Tasnia-Binte-Mamun/Circuit_design_EcoG_signal/BME_304_Project.pdf

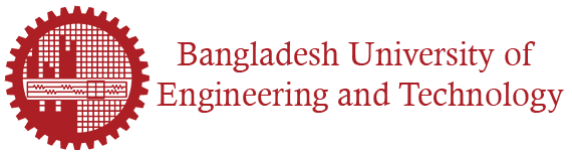
[picture p2: figure]

### Report on designing appropriate bio-signal measurement device

### for the ECoG signal

Course no: BME 304

Course Name: Biomedical Instrumentation and Measurements Sessional

Group No: 02

Date of submission: 28/08/2022

Submitted By | Submitted To
1.Tahmed Ahmed(1818006) | 1. Md. Kawsar Ahmed (https://bme.buet.ac.bd/profile/md-kawsar-ahmed/)
2.Atkia Atia Fariha(1818007) | Lecturer
3.Shamiur Rahman(1818008) | Dept. of Biomedical Engineering, BUET
4.Adhora Madhuri(1818009) | 2. Shams Nafisa Ali
5.Mahbuba Ferdaous(1818010) | Lecturer
6.Tasnia Binte Mamun(1818027) | Dept. of Biomedical Engineering, BUET
3. Samiul Based Shuvo
| Lecturer
| Dept. of Biomedical Engineering, BUET

## Circuit Schematics:

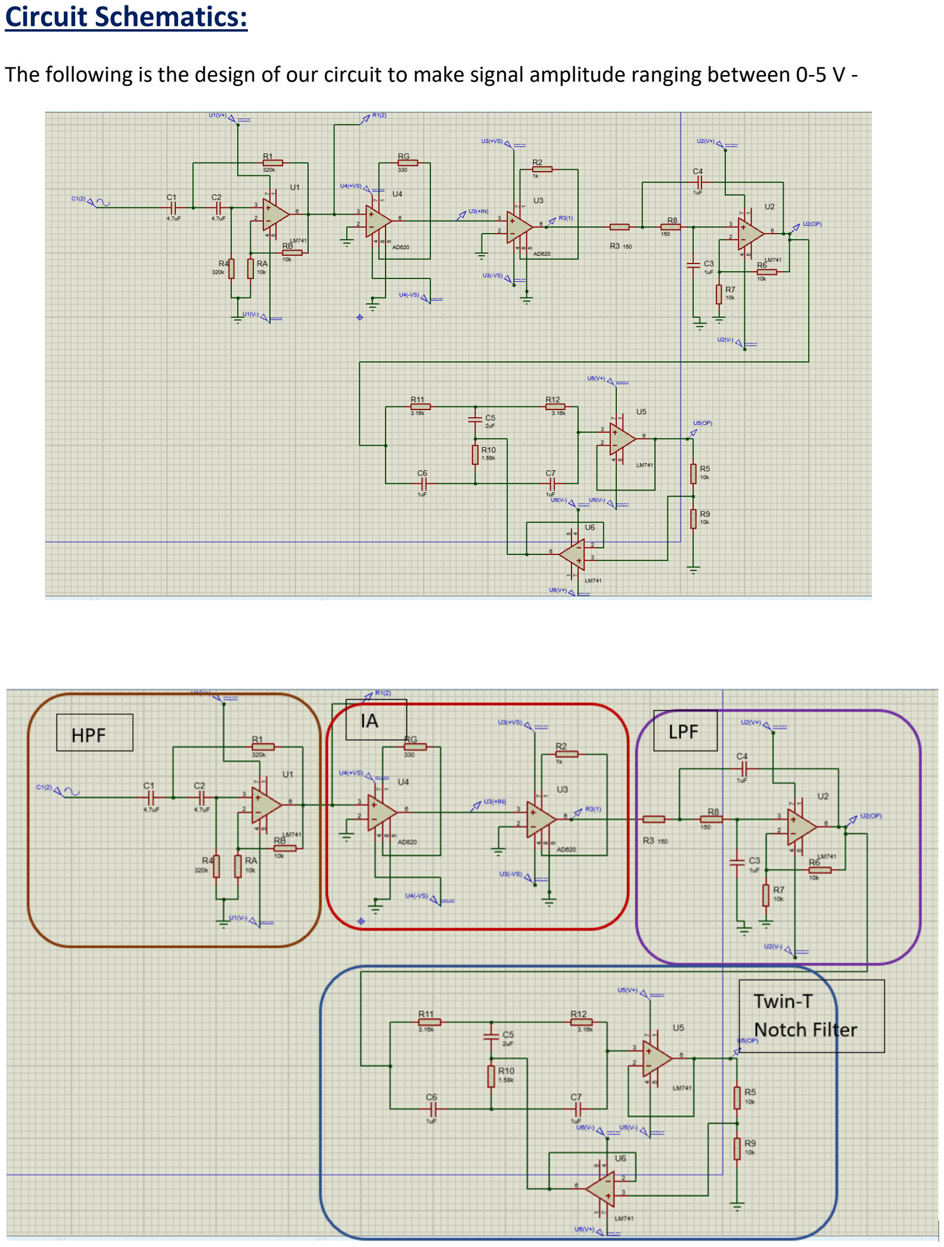
[picture p3: page 2]

The following is the design of our circuit to make signal amplitude ranging between 0-5 V -

## Gain and Cut off frequency derivation:

Second Order High Pass Filter:

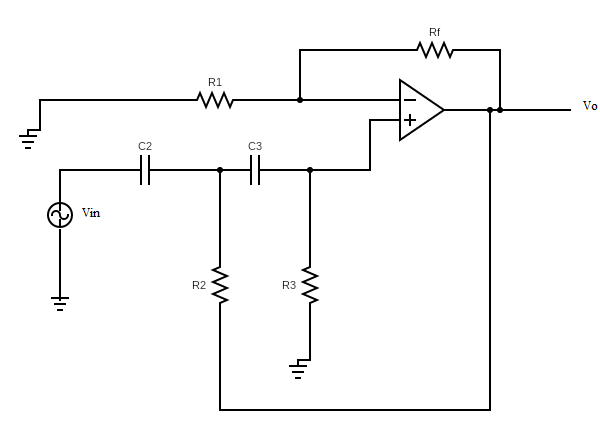
[picture p4: figure]
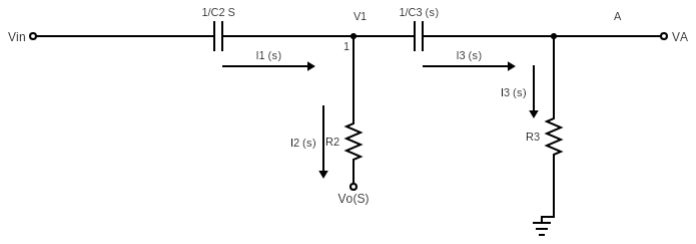
[picture p5: figure]

Now applying KCL at Node 1, we get

I1 (s) = I2 (s) + I3 (s)

or,

Vin − V1
1
C2S

=

V1 − V0
R2

+

V1 − VA
1
C3S

or, (Vin − V1)C2S =

V1 − V0
R2

+ (V1 − VA)C2S

or, VAC3S =

V1 − V0
R2

+ V1C2S + V1C2S − VinC2S

or, VA =

V1

(1+R2C3S+ R2C2S

)− V0− VinR2C2S
R2C3S
| (1)

Applying KCL in node A,

I3 = I4

or,

V1 − VA
1
C3S

=

VA − 0
R3

or, V1C3s =

VA
R3

+ VAC3S

or, V1 = VA

1 + R3C3S
R3C3S

Putting the value of V1 in equation (1),

VA =

[

VA

(1 + R3C3S

)
R3C3S

] (1 + R2C3S + R2C2S
) − V0 − VinC2R2S

R2C3S

or, VAR2C3S −

VA

(1 + R3C3S

)
R3C3S

(1 + R2C3S + R2C2S

) = −V0 − VinC2R2S

or, VA

R2R3C3

2S
2 − 1 − R2C3S − R2C2S − R3C3S − R2R3C3

2S
2 − R2R3C2C3S

2
R3C3S
= −V0 − VinC2R2S

or, −VA [
R2R3C2C3S

2 + S(R2C2 + R2C3 + R3C3
) + 1
R3C2S

] = −V0 − VinC2R2S

or, VA =

(V0 + VinSR2C2)R3C3S
R2R3C2C3S

2 + S(R2C2 + R2C3 + R3C3
) + 1

Now, V0 = AFVA [wℎere AF = 1 +

Rf
R1

]

or, V0 = AF[

(V0 + VinSR2C2)R3C3S
R2R3C2C3S

2 + S(R2C2 + R2C3 + R3C3
) + 1

]

or, (VinSR2C2)R3C3S = −R3C3SV0AF + V0[R2R3C2C3S

2 + S(R2C2 + R2C3 + R3C3
) + 1]

or,

V0

Vin

=

R2C2R3C3S

2AF
R2R3C2C3S

2 + S(R2C2 + R2C3 + R3C3 − R3C3AF) + 1)

=

S

2AF

S

2 + S

R2C2 + R2C3 + R3C3 − R3C3AF R2C2R3C3

+

1
R2C2R3C3

Now, comparing with the standard equation,

V0

Vin

=

A
S

2 + αwnS + wn

2

α =

R2C2 + R2C3 + R3C3 (1 − AF) √R2C2R3C3

wn =

1
√R2C2R3C3

or, 2πfc =

1
√R2C2R3C3

or, fc =

1
2π√R2C2R3C3

Where lower cut off frequency is fc

So, from equation we get,

AF = 1 +

Rf
R1

=

V0
VA

And cut off frequency, fc =

1
2π√R2C2R3C3

Gain, G = 20log(AF) = 20log (1 +

Rf
R1

)

INA 128:

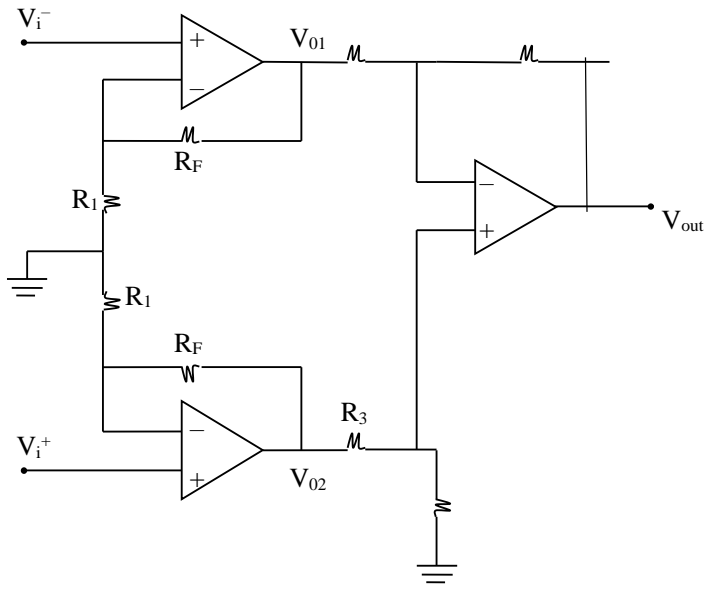
[picture p6: figure]
Vout

non inventing op
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
V01 = (1 −

RF
R1

) Vi
−

RF

R1

V02 Vi
+

–

+

V02 = (1 −

RF
R1

) Vi
+

V0 = V02 − V01 = (1 +

RF
R1

) ∆Vi
[AVi = Vi

+ − Vi
−]

If V01 on, VO2 off –

V

′ =

R4
R3

VO1

V02 on, V01 off-

VA =

R4
R4+R3

VO2

\ V

′′ =

R4
R4+R3

VO2 (1 +

R4
R3

)

=

R4
R4+R3

VO2

R3+R4
R3

=

R4
R3

VO2

VOut =

R4
R3

(VO2 − VO1

)

Vout =

R4
R3

(1 +

RF
R1

) ∆Vi

RG=2R1

RG=2R1

G =

R4
R3

(1 +

RF
R1

)

If R4 = R3, G = 1 +

2RF
RG

2

nd order low pass filter:

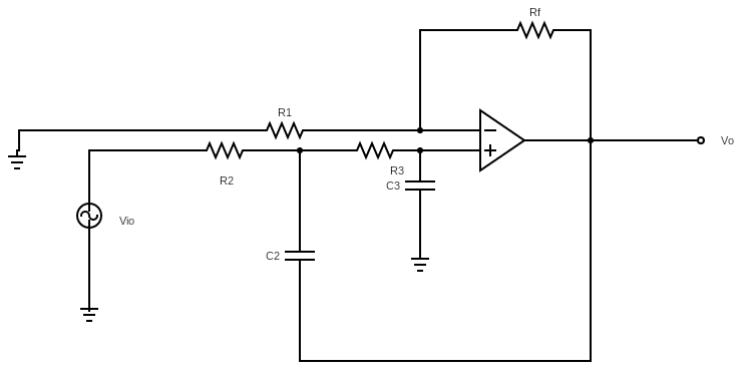
[picture p7: figure]

Transfer function:

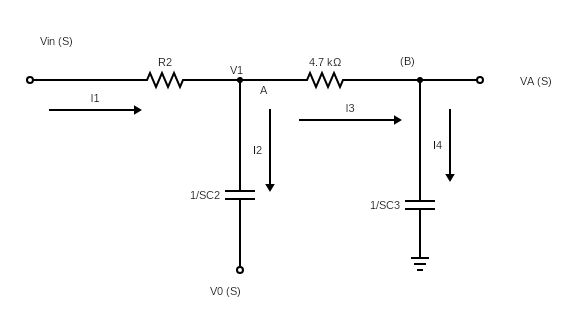
[picture p8: figure]

KCl at node A,

I1 = I2 + I3

or,

Vin(s)−V1

(s)
R2

=

V1

(s)−V0

(s)
1/sC2

+

V1

(s)−VA(s)
R3

or,

Vin−V1
R2

= (V1 − V0

)SC2 +

(V1−VA)
R3

or,

Vin−V1
R2

= (V1 − V0

)SC2 +

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
= (V1 − V0

)SC2 +

V1
R3

− (

Vin−V1
R2

)

or,

VA
R3

=

V1SC2R2R3−V0SC2R2R3+V1R2−VinR3+V1R3 R2R3

or, VA =

V1

(SC2R2R3+R2+R3

)−V0SC2R2R3−VinR3
R2

.......(1)

KCl at node B:

I3 = I4

or,

V1−VA
R3

=

VA−0
1/SC3

or,

V1
R3

=

VA
R3

+ VA. SC3

or,

V1
R3

= VA (

1+SR3C3
R3

)

or, VA =

V1
1+SR3C3

........(2)

Replacing V1 = VA(1 + SR3C3

) from (2) in (1):

VA =

VA(1+SR3C3

)(SC2R2R3+R2+R3

)−V0SC2R2R3−VinR3
R2

or, R2VA − VA(1 + SR3C3

)(SC2R2R3 + R2 + R3

) = −V0SC2R2R3 − VinR3

or,VA[R2 − SC2R2R3 − R2 − R3 − S

2R2R3

2C2C3 − SR2C3R3 − SR3

2C3
] =
−V0SC2R2R3 − VinR3

or, VA(SC2R2 + 1 + S

2R2R3C2C3 + SR2C3 + SR3C3
) = V0SC2R2 + Vin

or, VA =

V0SC2R2+Vin
[S

2R2R3C2C3+S(R2C2+R3C3+R2C3 )+1]

Now, from the circuit-

V0 = (1 +

RF
R1

) VA = AFVA

Replacing VA,

V0 = AF [

V0SC2R2+Vin
S

2R2R3C2C3+S(R2C2+R3C3+R2C3 )+1

]

V0 = [S

2R2R3C2C3 + S(R2C2 + R3C3 + R2C3 ) + 1 − AFSR2C2

] = AF. Vin

V0

Vin

=

AF
S

2R2R3C2C3+S(R2C2+R3C3+R2C3−AFR2C2 )+1

Here is the transfer function.

Again, from standard LPF Transfer function,

V0

Vin

=

AF
S

2+αWaS+Wn

2

V0

Vin

=

AF/R2R3C2C3
S

2+S[

R2C2+R3C3+R2C3−AFR2C2
R2R3C2C3

]+

1
R2R3C2C3

So, Wn

2 =

1
R2R3C2C3

Wn =

1
√R2R3C2C3

or, fc =

1
2π√R2R3C2C3

Gain, G = 20log(AF) = 20log (1 +

Rf
R1

)

2

nd order Notch filter:

Here, β =

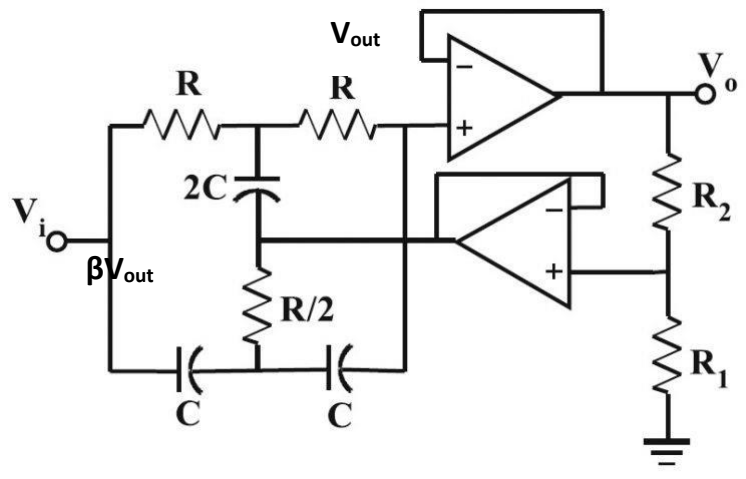
[picture p9: figure]
βVout; Vout

R1
R1+R2

Applying KCL at node A,

VA−Vin
R

+

VA−Vout
R

+

VA−βVout
1/2sC

= 0

⇒ VA (

2
R

+ 2sC) =

Vin+Vout
R

+

βVout
1/2sC

⇒ VA =

Vin+Vout(1+2βsRC)
2(1+sRC)
| (i)

Applying KCl at node B,

VB−βVout
R/2

+

VB−Vin
1/sC

+

VB−Vout
1/sC

= 0

⇒ VB (

2
R

+ 2sC) = (Vin + Vout)sC +

βVout
R/2

⇒ VB =

(Vin+Vout)sRC+2βVout
2(1+sRC)

......(ii)

Applying KCl at node P,

Vout−VA
R

+

Vout−VB
1/sC

= 0

Vout (

1
R

+ sC) =

VA
R

+ sCVB

Vout =

VA+sRC VB
1+sRC

.........(iii)

Substituting (i) and (ii) into (iii), we get,

Vout =

Vin+Vout(1+2βsRC)+(Vin+Vout)s

2R

2C

2+2sRCβVout
2(1+sRC)

2

⇒ 2Vout(1 + sRC)

2 = Vin(1 + s

2R

2C

2
) + Vout(1 + s

2R

2C

2 + 4sRCβ)

⇒ Vout(2 + 4sRC + 2s

2R

2C

2 − 1 − s

2R

2C

2 − 4sRCβ) = Vin(1 + s

2R

2C

2
)

⇒

Vout

Vin

=

1+s

2R

2C

2

s

2R²C²+4sRC(1−β)+1

∴ H(s) =

s

2+

1
R2C2
s

2+

4s(1−β)
RC +

1
| R2C2

where wn

2 =

1
R²C²

⇒ wn =

1
RC

⇒ fn =

1
2πRC

Theoretical Calculation:

For High pass filter:

R2 = R3 = 320 kΩ, C2 = C3 = 4.7μF, R1 = RF = 10 kΩ

fc =

1
2π√R2C2R3C3

= 0.01 Hz

V0

Vin

= 1 +

RF
R1

= 1 +

10k
10k = 2

And gain, 20log (1 +

Rf
R1

) = 6.02 dB

For INA 128: We used 2 INA 128 to obtain optimum gain.

For 1st INA,

RF = 25 Kohm, RG = 330 ohm

G = 1 +

2RF
RG

G= 152.5

For 2nd INA,

RF = 25 Kohm, RG = 1 Kohm

G= 51

So, total gain = 152.5× 51 = 7777.5

For Low pass filter:

R2 = R3 = 150Ω
C2 = C3 = 1μF

fc =

1
2π√(150)
2×(10⁻⁶)

2

= 1061.03 Hz

V0

Vin

= 1 +

RF
R

= 1 +

10k
10k = 2

Gain, G = 20 log (

V0

Vin

) = 20 log(2) = 6.02 dB

For Notch filter:

R = 3.3kΩ, C = 1μF

fn =

1
2×π×3.3×10³×1×10⁻⁶ = 48.23 Hz

So, notch frequency is 48.23 Hz.

Total Gain:

V0

Vin

= 2× 7777.5 × 2 = 31110

As Vin = 0.1 mV, V0 = 3.111V

Hence, The signal amplitude is in the required range.

## Frequency response plot:

Practically observed:

As we need 10,000 gain for making the signal amplitude between 0-5V, this is hard to implement. Thereby we gained the signal by 10.

For Bandpass (without notch):

Vin= 0.5 V

Frequency | Gain(bandpass) | bandpass(V_out)
0.03 | 3.045766888 | 0.71
0.05 | 12.62887538 | 2.14
0.06 | 15.67807159 | 3.04
0.07 | 18.23380318 | 4.08
0.08 | 19.78899635 | 4.88
0.09 | 19.82452151 | 4.9
0.1 | 19.85990197 | 4.92
0.2 | 19.96518677 | 4.98
0.5 | 20.47327836 | 5.28
2 | 20.47327836 | 5.28
5 | 20.47327836 | 5.28
7 | 20.47327836 | 5.28
10 | 20.47327836 | 5.28
20 | 20.47327836 | 5.28
25 | 20.47327836 | 5.28
30 | 20.47327836 | 5.28
35 | 20.47327836 | 5.28

40 | 20.47327836 | 5.28
42 | 20.47327836 | 5.28
45 | 20.47327836 | 5.28
48 | 20.47327836 | 5.28
50 | 20.47327836 | 5.28
52 | 20.47327836 | 5.28
55 | 20.47327836 | 5.28
58 | 20.47327836 | 5.28
60 | 20.47327836 | 5.28
65 | 20.47327836 | 5.28
70 | 20.47327836 | 5.28
75 | 20.47327836 | 5.28
80 | 20.47327836 | 5.28
85 | 20.47327836 | 5.28
90 | 20.47327836 | 5.28
100 | 20.47327836 | 5.28
120 | 20.47327836 | 5.28
150 | 20.47327836 | 5.28
200 | 20.47327836 | 5.28
250 | 20.47327836 | 5.28
300 | 20.47327836 | 5.28
350 | 20.47327836 | 5.28
400 | 20.47327836 | 5.28
450 | 20.47327836 | 5.28

500 | 20.47327836 | 5.28
550 | 20.47327836 | 5.28
600 | 20.47327836 | 5.28
650 | 20.47327836 | 5.28
700 | 20.47327836 | 5.28
750 | 20.47327836 | 5.28
800 | 19.78899635 | 4.88
900 | 19.78899635 | 4.88
950 | 19.42551697 | 4.68
1000 | 19.06552673 | 4.49
1050 | 19.04616019 | 4.48
1100 | 18.64947529 | 4.28
1200 | 18.23380318 | 4.08
1300 | 16.85218479 | 3.48
1400 | 16.33807679 | 3.28
1500 | 13.17929685 | 2.28
1600 | 13.90963353 | 2.48
1700 | 12.38186661 | 2.08
1800 | 12.38186661 | 2.08
2500 | 6.361266699 | 1.04
3000 | 4.506185635 | 0.84
3500 | 1.229049582 | 0.576

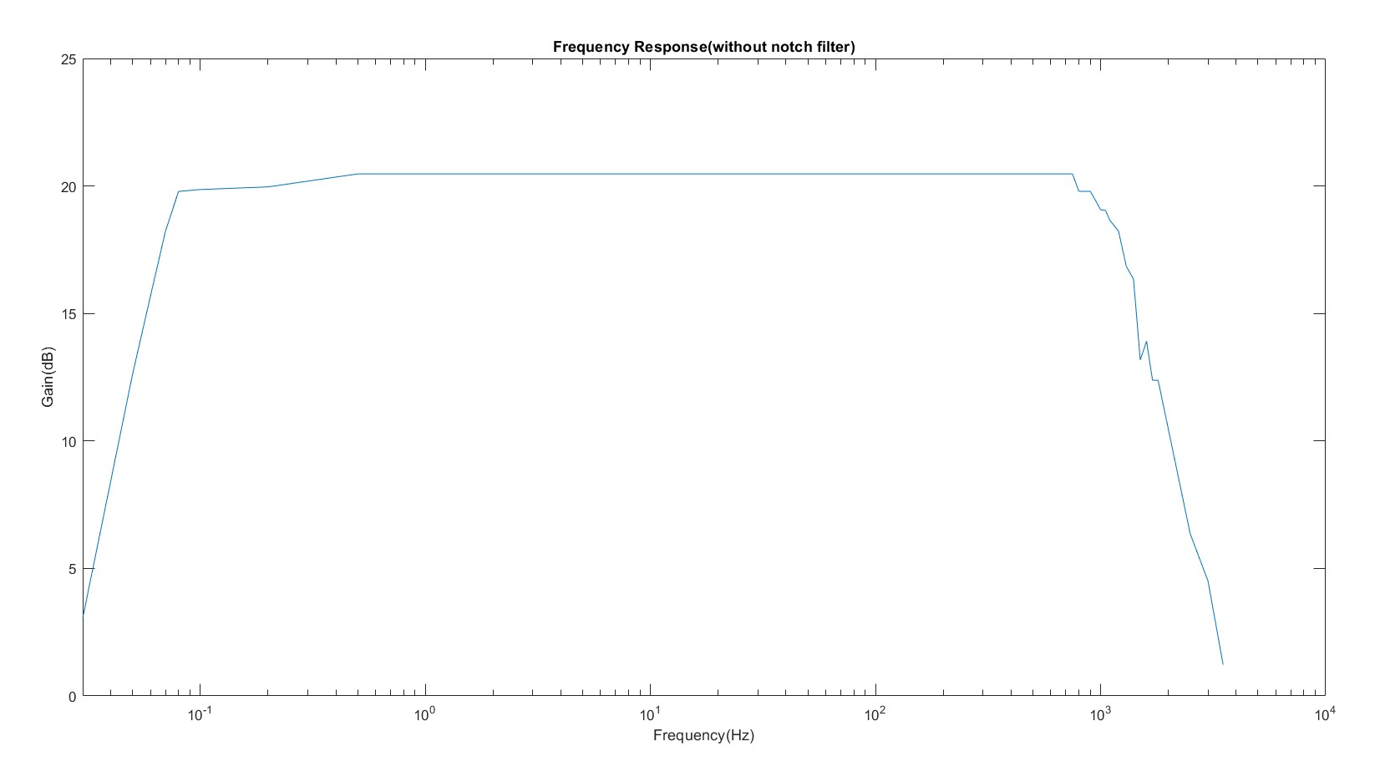
[picture p10: figure]

For Bandpass (with notch filter):

Vin= 0.5 V

Frequency | V_output(new) | Gain()
0.03 | 0.752 | 3.544957
0.05 | 2.16 | 12.70967
0.06 | 3.12 | 15.90369
0.07 | 3.92 | 17.88632
0.08 | 4.72 | 19.49944
0.09 | 5.52 | 20.85938
0.1 | 5.52 | 20.85938
0.2 | 5.52 | 20.85938

0.5 | 5.12 | 20.206 2 | 5.12 | 20.206 5 | 4.88 | 19.789 7 | 4.48 | 19.04616
10 | 4.08 | 18.2338
20 | 2.48 | 13.90963
25 | 1.84 | 11.31696
30 | 1.44 | 9.18785
35 | 0.944 | 5.52004
40 | 0.576 | 1.22905
42 | 0.464 | -0.64904
45 | 0.224 | -6.97444
48 | 0.096 | -14.334
50 | 0.084 | -15.4938
52 | 0.184 | -8.68304
55 | 0.324 | -3.7685
58 | 0.488 | -0.211
60 | 0.568 | 1.107567
65 | 0.84 | 4.506186
70 | 1.04 | 6.361267
75 | 1.24 | 7.889034
80 | 1.38 | 8.818182
85 | 1.54 | 9.771014
90 | 1.64 | 10.31748

100 | 2.08 | 12.38187
120 | 2.44 | 13.7684
150 | 3.04 | 15.67807
200 | 3.68 | 17.33756
250 | 4.08 | 18.2338
300 | 4.24 | 18.56792
350 | 4.48 | 19.04616
400 | 4.5 | 19.08485
450 | 4.65 | 19.36966
500 | 4.88 | 19.789
550 | 4.88 | 19.789
600 | 4.88 | 19.789
650 | 4.88 | 19.789
700 | 4.88 | 19.789
750 | 4.88 | 19.789
800 | 4.88 | 19.789
900 | 4.88 | 19.789
950 | 4.48 | 19.04616
1000 | 4.48 | 19.04616
1050 | 4.34 | 18.77039
1100 | 4.08 | 18.2338
1200 | 3.88 | 17.79723
1300 | 3.68 | 17.33756
1400 | 3.28 | 16.33808

1500 | 2.84 | 15.08697
1600 | 2.44 | 13.7684
1700 | 2.24 | 13.02556
1800 | 2.04 | 12.2132

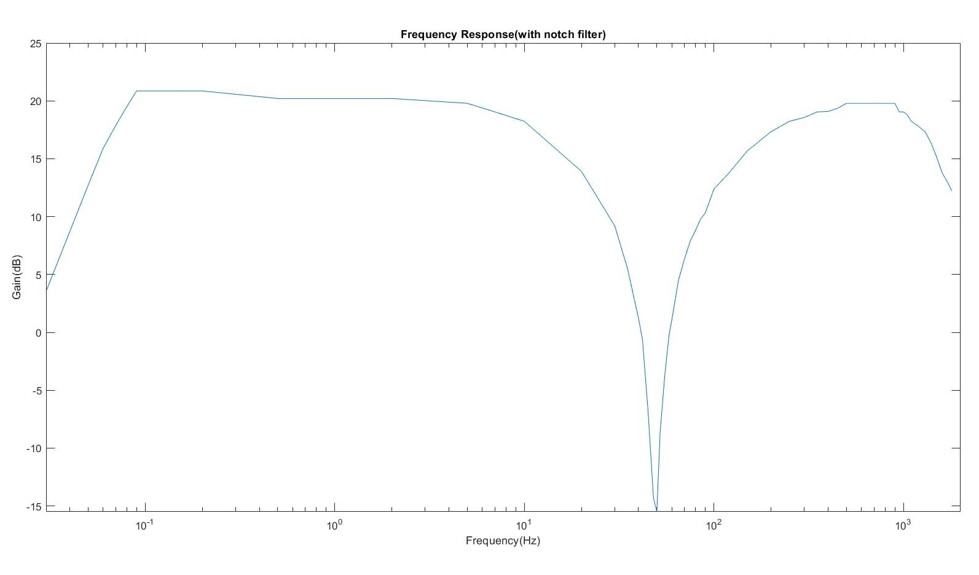
[picture p11: figure]

## Proteus simulation:

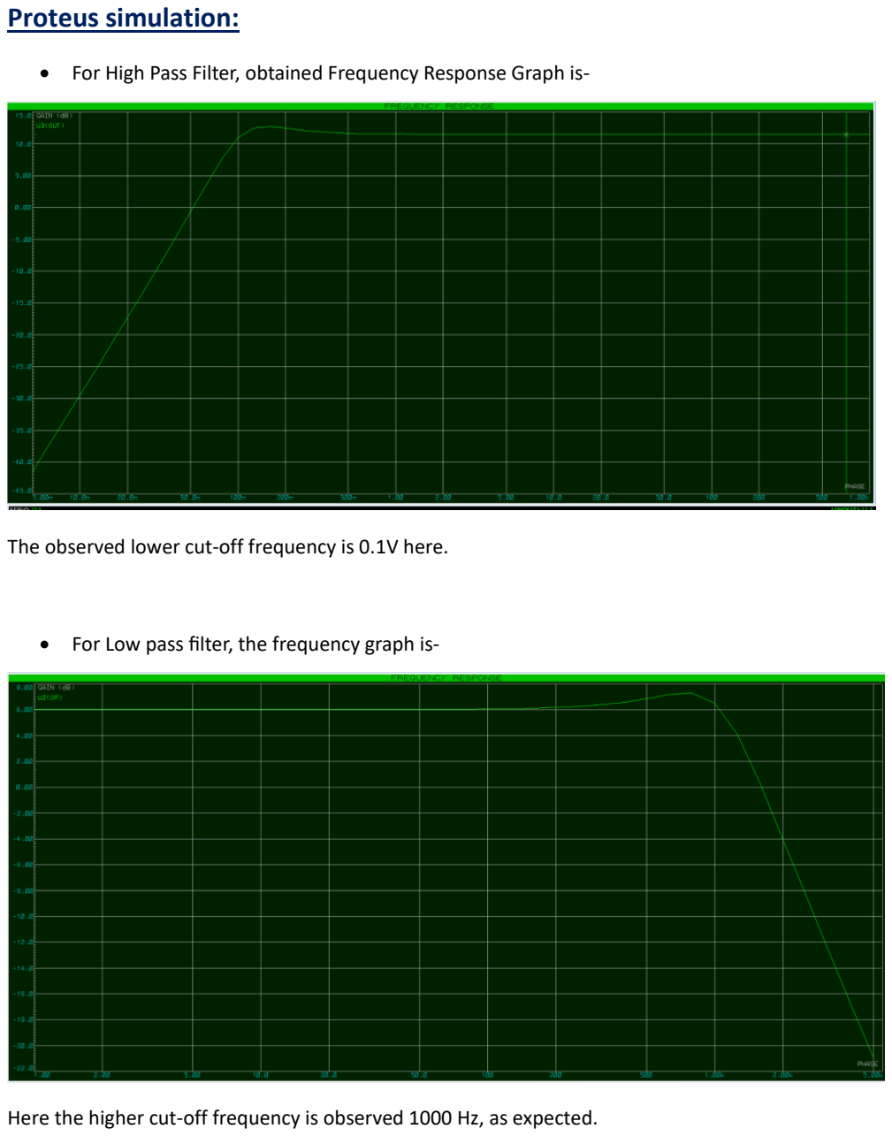
[picture p12: page 22]

- For High Pass Filter, obtained Frequency Response Graph is-

The observed lower cut-off frequency is 0.1V here.

- For Low pass filter, the frequency graph is-

Here the higher cut-off frequency is observed 1000 Hz, as expected.

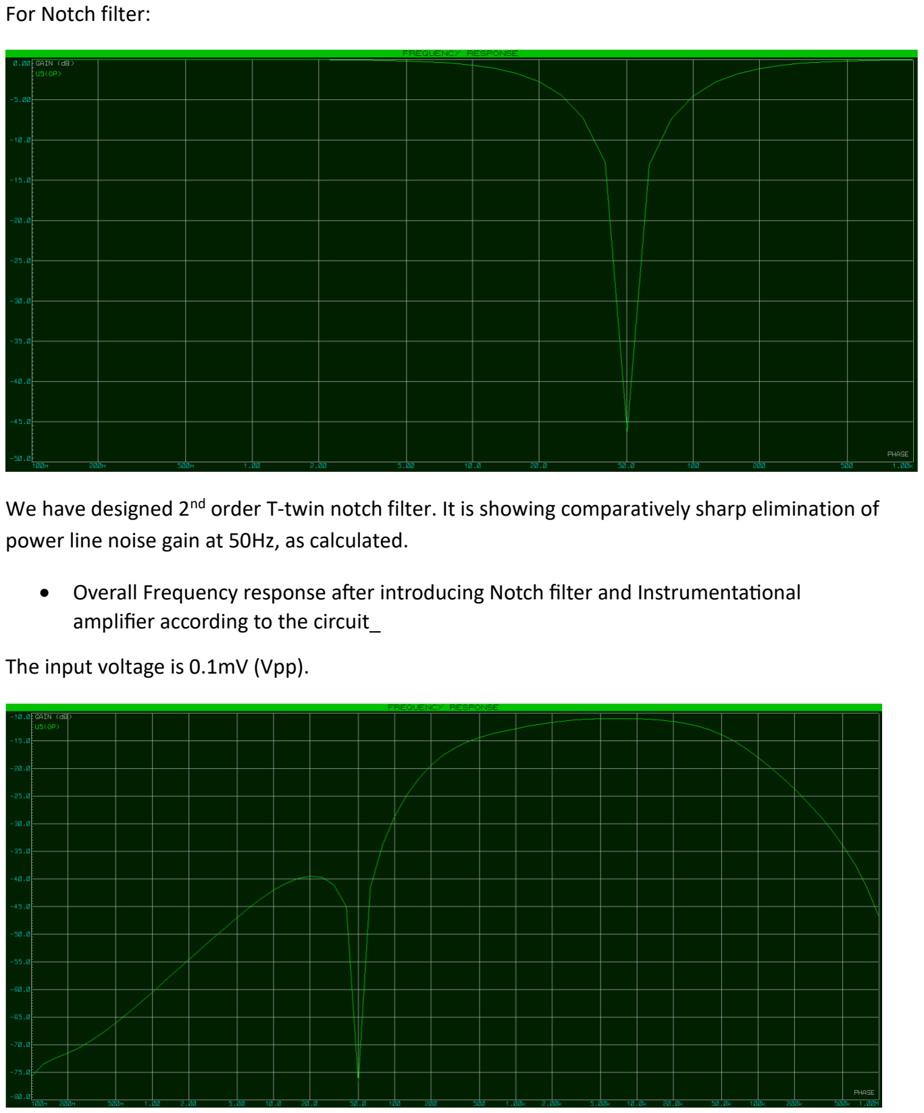
[picture p13: page 23]

For Notch filter:

We have designed 2nd order T-twin notch filter. It is showing comparatively sharp elimination of power line noise gain at 50Hz, as calculated.

- Overall Frequency response after introducing Notch filter and Instrumentational amplifier according to the circuit_

The input voltage is 0.1mV (Vpp).

## Discussion:

The cut off frequencies are quite distorted in the proteus simulation. Although the filters are individually working fine but altogether it finds difficulties in proper cascading. Specially, the calculated higher cut-off frequency was 1000Hz, we observed a very decrease in gain of the frequency band. But we got better result using additional 1st order LPF before the given 2nd order LPF and also increasing the input voltage up to 100mV.

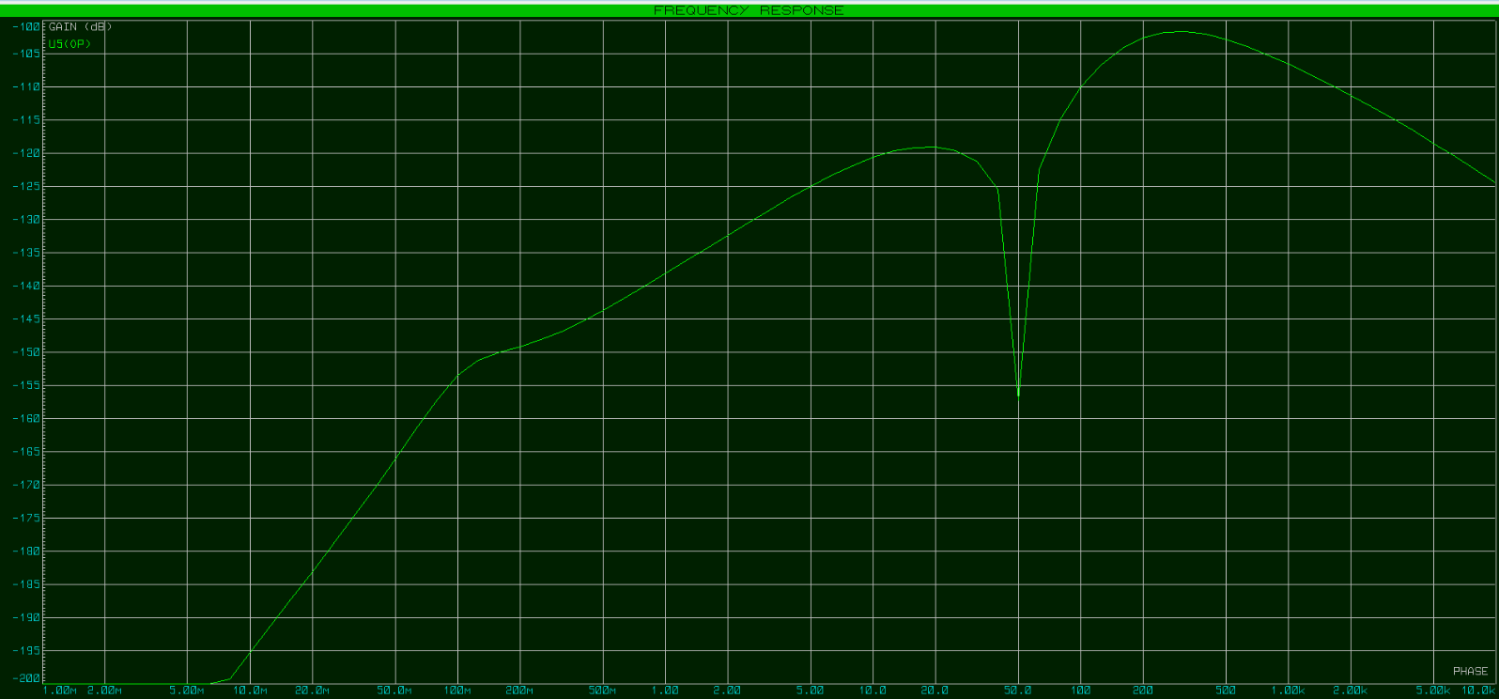
[picture p14: figure]

Thus, several iterations made us believe that proteus might face difficulties in calculating at lower range. And also, with the increasing order of the filter, we could obtain sharp and targeted result in cut-off frequency. But in question of feasibility of practical implementation, we have limited our circuit up to 2nd order filters.

Though INA 128 can give gain upto 1000, it was not working properly when we wanted that level of huge gain. So, we cascaded 2 INA to obtain a gain of 7777.5.

However, our circuit is working fine practically. Thus, it proves that the calculation is right. But it was hard to implement 10,000 gain and oscilloscope do not take input of 0.1 mV. Therefore, we implement a circuit to obtain 10 gain with input 0.5V. It worked as expected. There were some noise observed in the circuit due to environmental interference.

We used a notch filter to remove 50Hz powerline noise. However, it attenuated some of the signal of ECoG in the near that frequency.
