Tasnia-Binte-Mamun/Circuit_design_EcoG_signal/Images/With notch.png

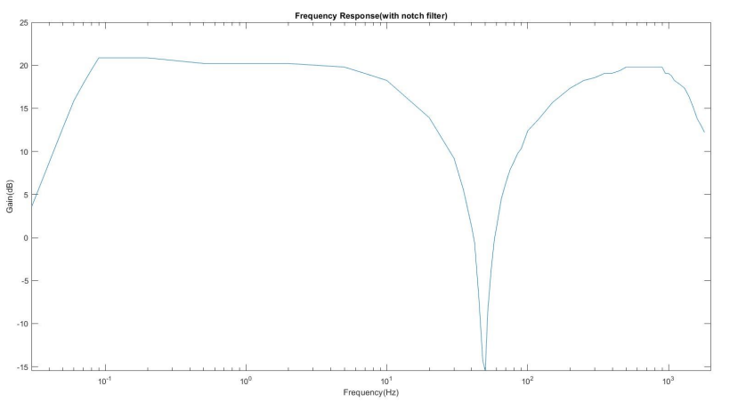
Images/With notch.png
