Tasnia-Binte-Mamun/Circuit_design_EcoG_signal/(list of files, drawings)

Other design files:
ECoG circuit simulation.pdsprj
